MikeGomezS/mexa/main.py

# ============================================================
#  MEXA — Programa Principal (main.py)
#  WRO Future Innovators 2026
#  Equipo: Bruno, Emilia y Majo
#
#  Orquestador: une los módulos y corre el ciclo de exhibición.
#  El QUÉ dice MEXA vive en modulos/contenido.py, el CÓMO se
#  acerca en modulos/navegacion.py y la conversación en
#  modulos/dialogo.py. Acá sólo se inicia, se coordina y se apaga.
#
#  Para ejecutar: python3 main.py
#
#  ANTES DE CORRER: seguir los pasos 1 a 10 del README.txt. Están
#  ahí y NO acá a propósito. Este encabezado repetía las mismas
#  instrucciones, y el 2026-09-17 se encontró que las dos copias
#  habían divergido: las dos pedían `espeak` cuando el código llama
#  a `espeak-ng`, y `llama3.2:3b` cuando modulo_ia.py usa
#  `llama3.2:1b`. Dos copias de una instrucción no son un respaldo:
#  son dos lugares donde equivocarse y uno solo que alguien corrige.
#  UNA sola fuente de verdad — el README.
# ============================================================

import time

from modulos.modulo_ia          import warmup_llm
from modulos.modulo_tts         import presintetizar
from modulos.modulo_audio       import calibrar_ruido_ambiente
from modulos.modulo_sensores    import iniciar_sensores, detectar_persona
from modulos.modulo_motores     import iniciar_motores, detener
from modulos.modulo_camara      import (iniciar_camara, diagnosticar_enfoque,
                                        apagar_camara)
from modulos.modulo_proyector   import (iniciar_proyector, pantalla_bienvenida,
                                        apagar_proyector)
from modulos.modulo_brazos      import iniciar_brazos, cerrar_brazos
from modulos.conexion_arduino   import cerrar_conexion
from modulos.navegacion         import acercarse_a_usuario, retroceder
from modulos.dialogo            import ciclo_interaccion, esperar_activacion, Resultado
from modulos                    import contenido


def _presintetizar_todo() -> None:
    """Pre-sintetiza con Piper todas las frases fijas al arrancar para
    reproducción instantánea durante la interacción (sin latencia de síntesis)."""
    print("[MAIN] Pre-sintetizando frases fijas...")

    # Prompt de idioma (siempre en inglés, antes de saber la preferencia).
    frases = [
        "Hi, I am MEXA. Would you prefer Spanish or English?",  # _seleccionar_idioma
        "Please say 'español' or 'English'.",                   # _seleccionar_idioma
    ]

    # Frases dependientes del idioma y de cada civilización.
    for idioma in ("es", "en"):
        f = contenido.FRASES[idioma]
        nombres_civ = contenido.nombres_ofrecidos(idioma)
        oferta = ", ".join(nombres_civ)
        frases.append(f["saludo_civ"].format(oferta=oferta))
        frases.append(f["no_reconocio"].format(oferta=oferta))
        frases.append(f["no_entendio"])
        frases.append(f["despedida"])
        for nombre in nombres_civ:
            frases.append(f["intro_video"].format(nombre=nombre))
            frases.append(f["post_video"].format(nombre=nombre))

    for texto in frases:
        presintetizar(texto)

    print(f"[MAIN] {len(frases)} frases listas.")


def iniciar_todo():
    """Inicializa todos los módulos del robot."""
    print("=" * 50)
    print("  MEXA — Iniciando sistema...")
    print("=" * 50)

    iniciar_sensores()
    iniciar_motores()
    iniciar_camara()
    iniciar_proyector()
    iniciar_brazos()

    pantalla_bienvenida()

    # Optimizaciones de latencia: pre-sintetizar frases fijas y precalentar el
    # LLM para que la primera respuesta de IA no pague el costo de carga del modelo.
    _presintetizar_todo()
    warmup_llm()

    # DESPUÉS de la pre-síntesis a propósito: la cámara puede capturar 40 fps
    # de imagen inútil si el lente está velado, y el autofocus necesita unos
    # segundos para asentarse. Esos segundos ya los gastó el arranque acá
    # arriba, así que el diagnóstico sale gratis y llega a tiempo — antes de
    # que MEXA reciba al primer visitante y "no detecte caras" sin explicar
    # por qué.
    diagnosticar_enfoque()

    # ÚLTIMO paso a propósito: mide el ruido de la sala con todo ya
    # encendido (ventilador del proyector, cara animada) y con MEXA
    # callada. Ese ruido es el que va a haber durante toda la visita,
    # así que es el que el umbral de voz tiene que descontar. Calibrar
    # antes de encender el proyector daría un piso optimista.
    calibrar_ruido_ambiente()

    print("[MAIN] Todos los módulos iniciados. MEXA listo.")


def apagar_todo():
    """Apaga los módulos al salir (los GPIO viven en el Arduino, no en la Pi)."""
    print("[MAIN] Apagando MEXA...")
    detener()
    cerrar_brazos()
    cerrar_conexion()   # cierra el puerto serial compartido (un solo Arduino)
    apagar_camara()
    apagar_proyector()
    print("[MAIN] MEXA apagado correctamente.")


# Tras oír "comencemos", cuánto espera al PIR antes de volver a dormir (despertar falso).
ACTIVACION_PIR_TIMEOUT_S = 20


def _esperar_persona(timeout: float) -> bool:
    """Espera a que el PIR detecte a alguien, hasta `timeout` segundos.
    Devuelve True si apareció, False si venció el tiempo (nadie llegó)."""
    fin = time.time() + timeout
    while time.time() < fin:
        if detectar_persona():
            return True
        time.sleep(0.5)
    return False


def ciclo_principal():
    """
    Flujo de exhibición con activación por voz. MEXA duerme hasta que alguien
    dice "comencemos"; entonces detecta (PIR), se acerca, atiende y, al terminar,
    vuelve a dormir. Según el Resultado de ciclo_interaccion():
    APAGAR=apagar MEXA, ESPERAR=volver a reposo, REINICIAR=reiniciar en el lugar.
    """
    print("[MAIN] MEXA lista. Esperando activación por voz...")

    try:
        while True:
            # Reposo: dormir hasta oír "comencemos".
            esperar_activacion()

            # Activada: empezar la detección de la persona (PIR). Si nadie
            # aparece (despertar falso), volver a dormir en vez de colgarse.
            if not _esperar_persona(ACTIVACION_PIR_TIMEOUT_S):
                print("[MAIN] Activada pero nadie apareció. Vuelvo a reposo.")
                pantalla_bienvenida()
                continue

            print("[MAIN] ¡Persona detectada! Iniciando interacción.")

            # Centrar y acercarse al visitante con la cámara (lazo cerrado).
            # Guarda el recorrido para poder volver al punto de partida.
            camino = acercarse_a_usuario()

            # Atender al visitante. REINICIAR = volver a empezar en el lugar.
            resultado = ciclo_interaccion()
            while resultado is Resultado.REINICIAR:
                resultado = ciclo_interaccion()

            # Deshacer el acercamiento: MEXA retrocede a donde empezó.
            retroceder(camino)

            if resultado is Resultado.APAGAR:
                break

            # ESPERAR → volver a reposo, esperando otra activación por voz.
            pantalla_bienvenida()
            print("[MAIN] Interacción completada. Volviendo a reposo...")

    except KeyboardInterrupt:
        print("\n[MAIN] Interrupción detectada (Ctrl+C).")
    finally:
        apagar_todo()


# ── Punto de entrada ────────────────────────────────────────
if __name__ == "__main__":
    iniciar_todo()
    ciclo_principal()
