MikeGomezS/mexa/(commit log)

2026-06-15 refactor: reorganizar codigo en paquete modulos/ y tests/
    - Modulos, config, conexion_arduino, conocimiento y _cara_animada -> modulos/ (paquete)
    - Imports internos pasados a relativos (from .config, etc.)
    - Rutas de assets (media/, modelo_vosk_es) corregidas con '..' al subir un nivel
    - main.py importa desde modulos.*
    - test_flujo.py -> tests/ con bootstrap de sys.path
    - modulos/__init__.py creado
2026-06-15 feat(brazos): implementar gesto de servos en firmware
    - Servo.h con barrido no bloqueante (millis) en pines D10/D11
    - 'H' activa gesto al hablar, 'P' vuelve a reposo
    - brazosReposo() en setup para posicion inicial
    - Corregida doc de pines en modulo_brazos.py (D9/D10 -> D10/D11, D9 lo usa Motor 3)
    - Angulos parametrizados (BRAZO_REPOSO/MIN/MAX) para ajuste mecanico
2026-06-16 feat(sensores): mover presencia y evasion de paredes al Arduino Mega
    Presencia (2x PIR) y ultrasonicos (2x HC-SR04) pasan a leerse en el
    firmware del Arduino Mega; el serial se vuelve bidireccional.
    Firmware (mexa.ino):
    - corrige pines de servos (der=10, izq=11)
    - lee 2 PIR (der=24, izq=22) y reporta "PRES:0/1" (OR, cambio+heartbeat)
    - agrega 2 HC-SR04 (der TRIG29/ECHO28, izq TRIG31/ECHO30)
    - evitarPared() frena solo en giros (R->derecho, L->izquierdo), umbral 15cm
    - medicion con pulseIn de timeout corto (pines en PORTA no admiten interrupts)
    Pi:
    - conexion_arduino.py: agrega RX no bloqueante (_bombear, hay_presencia)
    - modulo_sensores.py: elimina RPi.GPIO, delega presencia en el serial
    -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
    [conexion_arduino.py, config.py, main.py, mexa.ino, modulo_sensores.py]
2026-06-16 feat(flujo): migrar optimizaciones de latencia y despedida por idioma a main.py
    - pre-sintetizar frases fijas (Piper) y precalentar el LLM al iniciar
    - despedida y no_entendio respetan el idioma elegido (como test_flujo)
    - agregar clave no_entendio a _FRASES (es/en)
    - eliminar hablar_despedida/hablar_no_entendio (codigo muerto sin llamadores)
    - limpiar import en tests/test_flujo.py
2026-06-16 chore(arduino): eliminar sketches legacy motores.ino y brazos.ino
    Superados por el firmware unificado arduino/mexa/mexa.ino (un solo Arduino
    = un solo sketch). El motores.ino vacio era el que corria y causaba que
    los motores no respondieran.
2026-06-16 fix(arduino): corregir puerto serial a /dev/ttyACM0 (Mega 2560 R3 original)
    La placa real es un Arduino Mega 2560 R3 genuino (USB 2341:0042, CDC ACM)
    en /dev/ttyACM0, no un clon CH340 en /dev/ttyUSB0. Con el puerto anterior
    el software no se conectaba al Arduino.
    [config.py]
2026-06-16 test(arduino): script interactivo de prueba manual de motores y brazos
    Lee una tecla a la vez y envia el comando de una letra al firmware
    (F/B/R/L/S, 1-4 identificar motor, H/P brazos). Hilo lector muestra
    OK/PRES/WALL. Al salir manda S+P (stop + reposo) por seguridad.
2026-06-16 feat(flujo): cerrar loop continuo de atencion en ciclo_principal
    ciclo_interaccion ahora propaga el retorno de _ciclo_preguntas
    (True=apagar, False=esperar persona, None=reiniciar) y ciclo_principal
    atiende visitante tras visitante en vez de una sola interaccion. Activa
    la logica de _PALABRAS_REINICIO/_PALABRAS_ADIOS que estaba muerta.
2026-06-16 test(sensores): agregar prueba end-to-end de presencia PIR
    Valida el camino Arduino (PRES:0/1) -> conexion_arduino -> detectar_persona()
    con lectura en vivo. Incluye aviso de calentamiento del HC-SR501.
2026-06-17 feat(camara): degradar con gracia cuando no hay camara conectada
    iniciar_camara() ya no aborta el arranque si la camara no esta presente;
    capturar_frame/detectar_cara/posicion_cara devuelven None/False, por lo que
    orientarse_a_usuario(None) queda como no-op seguro.
2026-06-17 refactor(main): quitar control de ventiladores por software
    Los ventiladores quedan siempre prendidos por hardware. Se eliminan el import,
    la constante INTERVALO_TEMP_S, iniciar_ventiladores(), encender_siempre() y el
    bloque de control termico en ciclo_principal. Se borra modulo_ventiladores.py,
    que quedo huerfano.
2026-06-17 chore(tests): eliminar test_flujo.py
    El flujo de interaccion ya vive en main.py (validado en hardware). test_flujo.py
    era una copia paralela que divergio (su _ciclo_preguntas devolvia solo bool y usaba
    _esperar_wakeword en vez de la logica de reinicio por 'mexa'). Se elimina para dejar
    main.py como unica fuente de verdad.
2026-06-17 feat(flujo): avanzar 3s al frente al detectar persona
    Al detectar presencia por PIR, MEXA avanza hacia el frente durante
    AVANCE_PERSONA_S (3s) y frena antes de iniciar la interaccion. Se dispara
    una sola vez por visitante nuevo (no en el reinicio por 'mexa').
2026-06-17 test(camara): agregar script de validación de cámara IMX708
2026-06-17 fix(camara): agregar timeout a capturar_frame para no congelar MEXA si cae el CSI
    [modulo_camara.py]
2026-06-22 feat(camara): robustecer detección y exponer localización de cara
    La detección Haar evalúa cada frame aislado y parpadea (el test marcó 22
    cambios de estado en 20s con una persona quieta). Se agregan dos filtros
    según el modo de uso:
    - detectar_cara(): filtro de persistencia (debounce temporal) con umbrales
    asimétricos (confirma presencia en 2 frames, la suelta en 4) para
    detección CONTINUA en loop.
    - posicion_cara(): muestreo por consenso (5 frames, voto por mayoría) para
    el modo one-shot, donde no hay loop sobre el cual suavizar.
    Además se expone localizar_cara() -> (posicion, tamano_rel), que devuelve la
    cara más grande con su tamaño relativo como proxy de distancia, p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
2026-06-22 feat(flujo): acercar a la persona en lazo cerrado con cámara
    Reemplaza el avance ciego de tiempo fijo (mover_por_tiempo adelante 3s) por
    acercarse_a_usuario(): un lazo cerrado que centra al visitante Y se le acerca
    usando el tamaño de la cara como proxy de distancia.
    El lazo vive en main.py (composition root) porque combina sensado (cámara) y
    actuación (motores), sin acoplar los módulos entre sí. Patrón pulso-frenar-
    sensar: nunca avanza a ciegas. Prioriza centrar antes que avanzar y frena al
    alcanzar TAMANO_CARA_OBJETIVO. Cortes de seguridad por timeout y por pérdida
    sostenida de cara. Loguea el tamaño de la primera cara enganchada como dato
    de calibración para el robot real.
    La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
2026-06-23 feat(vision): detección robusta con YuNet y acercamiento en dos fases
    - camara: migrar de Haar a YuNet (FaceDetectorYN, DNN) con score mínimo
    alto para alimentar el lazo de motores sólo con caras de alta confianza;
    robusto a blur, contraluz y fondo cargado
    - main: refinar acercarse_a_usuario con avance continuo (sensa en marcha),
    corrección de rumbo por pulsos con asentamiento anti-blur y empuje ciego
    final al perder la cara por recorte de cercanía
    - tests: agregar scripts de diagnóstico y calibración (deteccion, motores,
    acercamiento, pulsos, avance)
    - agregar modelo face_detection_yunet_2023mar.onnx
    - gitignore: excluir frames de diagnóstico de cámara
2026-06-23 feat(flujo): retroceder al punto de partida deshaciendo el camino del acercamiento
    MEXA registra cada comando de motor (F/B/R/L/S) con su timestamp durante
    el acercamiento y, tras atender al visitante, deshace el recorrido en orden
    inverso (F<->B, R<->L) para volver a donde empezó.
    - registro_camino: logica pura calcular_camino_inverso() (testeada, 7/7) +
    RegistroCamino/retroceder() que se enganchan a la capa serial via un
    observador en conexion_arduino.enviar(). Imports de hardware perezosos
    para que el modulo corra en cualquier maquina.
    - retroceder() expone factor_duracion para corregir la asimetria
    avance/reversa (inercia, patinaje), pendiente de calibrar en hardware.
    - acercar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
    [calibrar_retroceso.py, conexion_arduino.py, main.py, registro_camino.py, test_registro_camino.py]
2026-06-24 feat(flujo): giro de centrado más fluido (PULSO_GIRO_S 0.25 -> 0.80)
2026-06-24 feat(interaccion): "terminar" apaga, "adios" espera al próximo, "empecemos de nuevo" reinicia
2026-06-24 refactor(arquitectura): separar main en contenido/navegacion/dialogo + Enum Resultado + fix matcher de voz
    [contenido.py, dialogo.py, main.py, modulo_camara.py, navegacion.py, test_camara.py]
2026-08-21 feat(idioma): MEXA bilingüe real — oído en inglés con segundo modelo Vosk
    El modelo Vosk español no tiene los fonemas /ɪ/ ni /ʃ/: con audio limpio
    todavía forzaba "English" contra su entrada léxica, pero con micrófono
    lejano y ruido de sala ese margen desaparecía y decodificaba cualquier
    cosa (medido: "web"). Un oído español no escucha inglés.
    - modulo_audio: segundo modelo Vosk (en-us) y gramática CERRADA para la
    pregunta de idioma — una pregunta cerrada merece un grafo cerrado: el
    decodificador elige entre 3 palabras, no entre 300 mil.
    - dialogo: el idioma elegido se propaga a TODA la conversación
    (escuchar_pregunta, elección de civilización, ciclo de preguntas)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
2026-08-21 fix(camara): elegir a QUIÉN mira MEXA, y arreglar el color que la dejaba ciega
    Con varias personas juntas MEXA no sabía a quién atender. Al medir sobre
    tests/diag_frames/ aparecieron dos problemas, uno encima del otro.
    1. ORDEN DE CANALES (la causa de fondo). _buscar_caras hacía un
    cvtColor(RGB2BGR) de más: picamera2 en 'RGB888' YA entrega los bytes
    en orden BGR, que es lo que YuNet espera. Se le estaba dando al
    detector una imagen con R y B cruzados. Medido sobre 20 frames reales:
    cruzado detecta cara en 6/20 (scores 0.38-0.89); correcto, en 17/20
    (scores 0.80-0.93), y desaparece un falso positivo sobre un reloj de
    pared. Ninguna muestra empeoró. Segunda evidencia,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
    [dialogo.py, modulo_camara.py, navegacion.py, test_seleccion_objetivo.py]
2026-08-21 feat(camara): mostrar en la corrida real a quién elige MEXA y por qué
    Validar la elección de objetivo exigía correr un diagnóstico aparte. Ahora
    el propio main.py lo cuenta: al enganchar un objetivo y al cambiar de
    persona, se imprime el puntaje de CADA cara visible, su tamaño, su posición
    y si mira a MEXA o está de perfil.
    [CAMARA] Objetivo: CAMBIA a 1 de 2 cara(s) visible(s).
    [CAMARA] -> puntaje=0.81 tam=22% derecha de frente (frontalidad=1.00)
    [CAMARA] puntaje=0.41 tam=22% izquierda de perfil (frontalidad=0.00)
    Habla sólo cuando pasa algo (enganche, cambio, objetivo soltado), nunca por
    frame: el lazo de acercamiento sensa decenas de veces por segundo y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
2026-08-21 chore(tests): borrar diagnostico_deteccion.py
    Su único trabajo era mostrar a quién elegía la cámara, y eso ahora lo dice
    MEXA sola durante la corrida real (líneas "[CAMARA] Objetivo:"). Mantener
    una segunda copia de la misma cadena de percepción sólo garantizaba que
    las dos se fueran separando con el tiempo.
2026-08-21 feat(ultrasonicos): MEXA mide la distancia REAL al visitante con 2 HC-SR04 frontales
    Antes MEXA cerraba el acercamiento con un empuje A CIEGAS de 4 segundos: la
    cámara pierde la cara justo cuando más cerca está, y a partir de ahí el robot
    avanzaba a fe. Ahora hay dos ultrasónicos frontales que miden cuánto falta.
    Firmware (arduino/mexa/mexa.ino):
    - 2 HC-SR04 nuevos al frente (DER D53/D52, IZQ D51/D50) sumados a los laterales.
    - Emite "DIST:<izq>,<der>" mientras avanza y "STOP:<cm>" si frena solo.
    - El freno vive en el Arduino porque es un REFLEJO, no una decisión: la Pi puede
    estar decodificando voz cuando el visitante da un paso al frente; el Arduino no.
    - Se MIDE cada 60ms pero s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
2026-08-24 feat(tests): auditar qué palabras puede oír MEXA de verdad
    Una clave de CIVILIZACIONES cuya palabra no está en el léxico del modelo
    Vosk es código muerto: el match nunca se cumple y no hay forma de notarlo
    leyendo el código. El video existe, la clave existe, y el visitante igual
    recibe "no reconocí esa civilización" hasta que MEXA se rinde.
    Tres modos, de más barato a más caro:
    auditar → consulta el léxico con vosk_model_find_word. Instantáneo, sin
    micrófono. Responde "¿esta clave puede funcionar alguna vez?".
    tts → sintetiza con Piper, degrada a condiciones de sala y se lo da
    al mismo recognizer libre que usa escuchar_pregunta. Captura la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
2026-08-24 fix(voz): MEXA ya no proyecta el video que nadie pidió
    Dos bugs con el mismo síntoma —el visitante recibe una civilización que no
    eligió— y causas distintas.
    1. MATCH POR SUBCADENA. La clave "mexica" vivía dentro de "mexicana",
    "mexicano" y "mexican", que Vosk escribe seguido porque están en ambos
    léxicos. "quiero saber de la comida mexicana" proyectaba los Aztecas.
    Medido: 8 de 11 frases inocentes disparaban un video. Ahora se compara
    por PALABRA COMPLETA. Eso rompe el truco de que el singular cubra al
    plural, así que se agrega "aztecs": se verificó clave por clave, con
    sufijos s/es/as/os contra ambos léxicos, que era la única forma derivada
    que el recon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
    [contenido.py, dialogo.py, test_civilizaciones.py]
2026-08-26 fix(tests): recuperar la carpeta tests/ del repo, tapada por speechrecognition
    `python3 -m tests.test_idioma` fallaba con "No module named tests.test_idioma"
    para TODOS los tests del proyecto, aunque los archivos estén ahí y sus propios
    docstrings digan que se corren así. Se venía corriendo `python3 tests/x.py`
    como workaround sin saber por qué hacía falta.
    La causa es un choque de nombres: speechrecognition-3.14.5 publica un paquete
    `tests` de nivel raíz en site-packages. Sin __init__.py, la carpeta tests/ de
    este repo es un "namespace package": Python la anota como candidata pero SIGUE
    buscando, y en cuanto encuentra un paquete REGULAR con el mismo nombre más
    adelante en sys.path,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
2026-08-26 feat(vad): MEXA distingue la voz del visitante del ruido de la sala
    El VAD comparaba la energía del micrófono contra un número FIJO (300 RMS)
    calibrado en un cuarto tranquilo. Medido con el micrófono de MEXA en su propia
    sala, el piso de ruido va de 385 a 1615 RMS según el momento: el umbral estaba
    POR DEBAJO del ruido y el VAD ya estaba PEGADO —nunca juntaba 1.5s de silencio,
    se comía el timeout entero y le entregaba ruido a Vosk— antes de llegar a la
    expo. Un número fijo mide VOLUMEN, no voz, y falla en las DOS direcciones: en
    sala ruidosa nunca cierra, y con un visitante que habla bajo nunca abre.
    UMBRAL RELATIVO AL RUIDO MEDIDO (modulos/vad.py, nuevo)
    - El umbral se deriva de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
2026-08-27 fix(vad): el calibrador de voz medía contra un detector que no corría
    El veredicto de tests/calibrar_umbral_voz.py salía de umbral_desde_piso(),
    que usa _FACTOR_UMBRAL (3.0), el umbral del DetectorVoz de energía. Cuando
    Silero está instalado el que corre es DetectorVozNeural, cuya compuerta es
    _FACTOR_ENERGIA_NEURAL (2.0) — más baja a propósito, porque ahí la energía
    no tiene que rechazar golpes: de eso ya se encarga Silero.
    Medido en sala con piso 357: juzgaba contra 1071 en vez de 714 y reportaba
    "JUSTO 1.1x" para voz baja cuando el margen real era 1.6x. Falsa alarma.
    Causa raíz: cada detector exponía su umbral con un nombre distinto
    (.umbral vs .umbral_energia), así que el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
    [calibrar_umbral_voz.py, vad.py]
2026-08-27 feat(tests): medir si la señal cae como 1/distancia sin fuente reproducible
    Para decidir la altura del micrófono hace falta saber cuánto se gana
    subiéndolo. Altura y distancia son la MISMA hipotenusa
    (√(horizontal² + Δaltura²)), así que si la señal cae como 1/distancia
    alcanza con medir a distintas DISTANCIAS —que es gratis, caminás— para
    predecir el efecto de cambiar la ALTURA, sin desmontar nada.
    El problema es que la fuente de sonido es una persona y una persona no es
    reproducible. Medido con el mismo usuario, misma sala y mismo día: la
    relación entre su "voz normal" y su "voz baja" pasó de 1.32x en una
    corrida a 3.72x en la siguiente. Ese ruido del instrumento es MAYO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
    [calibrar_distancia_voz.py]
2026-08-27 feat(audio): banco de pruebas del cancelador de eco, para saber si MEXA puede ser interrumpida
    MEXA se tapa los oídos mientras habla (_vaciar_buffer): nadie puede
    interrumpirla, hay que esperar el video entero. El commit c445133 cerró
    diciendo que el AEC "no es un pendiente sino otro proyecto" porque pygame y
    PyAudio no comparten reloj. ESO ERA INCORRECTO. Cierto entre aplicaciones,
    irrelevante acá: PipeWire ve los dos lados con el mismo reloj y puede restar.
    El AEC es viable en la Pi actual, sin comprar nada.
    Este commit NO habilita el barge-in. Agrega la config y el banco de pruebas
    que tiene que aprobarla antes de tocar una línea del camino de audio.
    LA CONFIG, AHORA EN EL REPO (con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
2026-08-27 fix(audio): medir la referencia, sin la cual el veredicto del AEC es una adivinanza
    La primera PRUEBA C corrida por una persona dio "NO SIRVE PARA BARGE-IN" sobre
    una medición físicamente imposible:
    PRUEBA A (solo eco) crudo 2895 RMS
    PRUEBA B (solo voz) crudo 1631 RMS
    PRUEBA C (las dos) crudo 1392 RMS
    Dos fuentes suman EN POTENCIA: juntas tendrían que dar ~3323 y nunca pueden
    dar menos que la más fuerte por separado. Medir 1392 significa que el parlante
    no estaba reproduciendo durante la C. El script verificaba que hubiera eco en
    A y voz en B, pero nunca que en C estuvieran LAS DOS, así que emitió el
    veredicto que más importa —el del barge-in— sobre datos que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
    [calibrar_aec.py]
2026-08-27 feat(audio): MEXA escucha por PipeWire, para que el cancelador de eco le sirva de algo
    MEXA tenía un pie adentro y otro afuera del servidor de sonido: la salida
    (pw-play del TTS, cvlc del video) iba por PipeWire, pero la entrada la abría
    PyAudio directo contra ALSA. PipeWire nunca veía el micrófono, así que no
    podía restarle nada. El cancelador de eco estaba cargado, medido y aprobado
    —22.1 dB sobre el eco, la voz sobreviviendo en doble conversación— y no
    compraba NADA, porque el audio que llegaba a Vosk nunca pasaba por él.
    Ahora la captura sale de un `pw-record` apuntando a `mexa_aec_source`.
    POR QUÉ pw-record Y NO pipewire-alsa
    El plugin ALSA estaba disponible en apt y el c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
2026-08-27 fix(audio): no confiar en el cancelador sin mirar a qué micrófono está enchufado
    elegir_nodo() verificaba que `mexa_aec_source` EXISTIERA y se conformaba con
    eso. No alcanza, y el modo de falla es el peor posible.
    El módulo echo-cancel se carga junto con el daemon de PipeWire, ANTES de que
    los dispositivos estén publicados. Si el iTalk-02 todavía no existe,
    target.object no encuentra a quién apuntar y WirePlumber engancha la captura
    al dispositivo por defecto de ese instante. Visto en hardware el 2026-08-27:
    quedó enganchado a un micrófono Bluetooth. El nodo seguía existiendo, seguía
    entregando muestras, y eran CEROS. Sin error, sin log, sin nada: MEXA
    completamente sorda en plen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
    [captura.py, test_captura.py]
2026-08-27 feat(tests): probar si MEXA ENTIENDE a quien le habla encima, no si lo oye
    tests/calibrar_aec.py mide ENERGÍA y ya dio su veredicto: la voz sobrevive a
    la doble conversación. Pero su PRUEBA C aprobó con 1830 RMS de salida, y ese
    número es compatible con la voz y el eco fugado MEZCLADOS — con un solo canal
    no hay forma de separarlos. Que la voz tenga volumen no prueba que se
    entienda, y lo que MEXA necesita es entender.
    Eso sólo lo contesta el reconocedor. Este script mide la decisión REAL de
    MEXA: `_dijo(texto, _PALABRAS_ACTIVACION)` sobre lo que devuelve
    `escuchar_multilingue()`. No un proxy ni una transcripción parecida: si
    despierta o no despierta.
    EL DISEÑO: DOS CAMINOS, UNA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
2026-08-27 fix(tests): el wake word era la métrica equivocada y hacía ganar al micrófono sucio
    La primera corrida real con voz humana dio este veredicto:
    el visitante DESPERTÓ a MEXA con cancelador 2/3 sin cancelador 3/3
    SIRVE, PERO EL CANCELADOR NO ES LO QUE LO LOGRA
    Ese veredicto es engañoso, y la culpa es de la métrica que eligió este
    script, no del cancelador. Lo que devolvió cada camino en el mismo intento,
    sobre la MISMA voz y el MISMO instante:
    con cancelador "comencemos" 1 palabra, 0 fantasma
    micrófono crudo "hoy vamos a de comprar el 9 palabras, 8 fantasma
    imperio comencemos hola"
    En los tres intentos: 5 palab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
    [probar_barge_in.py]
2026-08-27 fix(tests): avisar CUÁNDO hablar con tiempo de reaccionar, y no inclinar la comparación
    La señal para hablar era un "¡AHORA!" impreso de golpe, seguido de inmediato
    por la ventana de escucha. No alcanza: para cuando la persona lee el aviso,
    el video ya está sonando fuerte, la consola está escupiendo líneas del
    reconocedor y la ventana ya arrancó. En la corrida real el aviso se perdió y
    la medición se fue con él.
    Y el modo de falla es traicionero: una señal perdida produce "el visitante no
    despertó a MEXA", que se lee como un fallo del CANCELADOR cuando en realidad
    es un fallo del BANCO DE PRUEBAS. Un test que no distingue esas dos cosas
    miente sobre lo que mide.
    Ahora hay cuen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
    [probar_barge_in.py]
2026-09-09 fix(audio): buscar el micrófono en el grafo, porque un nombre a mano no avisa cuando muere
    El nodo de captura del cancelador apuntaba a un nombre escrito a mano:
    target.object = "alsa_input.usb-Clip-on_USB_microphone_iTalk-02-00.mono-fallback"
    El 2026-09-08 se cambió el clip-on por un lavalier inalámbrico y ese nombre
    dejó de existir. Lo grave no fue quedarse sin nodo: fue que NADIE SE ENTERÓ.
    pw-record --target <nodo-que-no-existe> NO FALLA.
    Cae al micrófono por defecto y sigue entregando audio como si nada. Medido
    ese día: 156614 bytes de audio REAL leídos de un nodo inexistente, que
    resultaron ser el micrófono del parlante Bluetooth. O sea que la degradación
    "caigo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
    [captura.py]
2026-09-09 perf(voz): cortar a 0.9s de silencio, medido, en vez de esperar 1.5s siempre
    MEXA tardaba en darse por contestada. La espera de silencio era una constante
    global de 1.5 s: el visitante decía "español" y MEXA se quedaba escuchando
    un segundo y medio de nada antes de reaccionar.
    EL NÚMERO NUEVO ESTÁ MEDIDO, no elegido a ojo. Barrido con voz real y Silero:
    silencio tarda en cortar tolera pausas de hasta
    0.6 s +0.61 s 0.4 s
    0.8 s +0.84 s 0.6 s
    0.9 s +0.93 s 0.8 s <- elegido
    1.5 s +1.51 s 1.3 s (el valor viejo)
    No se baja a 0.6 aunque sea más rápido: "los... eh... olmec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
2026-09-09 fix(voz): un solo pw-play para toda la respuesta, que el corte era renegociar Bluetooth
    La voz se escuchaba cortada entre frase y frase. La causa no estaba en el
    sintetizador: _reproducir_con_volumen lanzaba UN pw-play POR ORACIÓN. Proceso
    nuevo, stream de PipeWire nuevo y —lo caro— una NEGOCIACIÓN NUEVA CON EL
    PARLANTE BLUETOOTH en cada punto seguido.
    Medido: 3 oraciones con un proceso por oración agregan +0.81 s de silencio
    repartido entre frases; con un solo stream abierto, +0.06 s.
    Ahora _abrir_reproductor() deja UN pw-play vivo comiendo PCM crudo por stdin
    para toda la respuesta.
    El segundo defecto era la DERIVA DE LOS SLEEPS. El envío de volumen a la cara
    dormía un tiempo f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
    [modulo_tts.py]
2026-09-09 perf(ia): dejar de reenviar en cada turno los hechos de las preguntas viejas
    El historial guardaba f"{contexto}\n\nPregunta: {pregunta}" completo, así que
    los ~400 caracteres de hechos de CADA pregunta vieja viajaban otra vez en
    cada turno: hasta 1200 caracteres de material ya consumido.
    Eso se paga caro. Procesar el prompt en esta Pi cuesta entre 5 y 25 segundos,
    MEDIDO, y es lo primero que espera el visitante — antes de que se genere un
    solo token. El historial existe para que MEXA entienda "¿y quién la
    construyó?", no para volver a suministrarle datos que ya usó.
    Ahora _mensajes() arma sistema + historial limpio + la pregunta actual CON
    sus hechos: el contexto va SÓLO en el turn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
2026-09-09 fix(conocimiento): MEXA no entendía en inglés porque las 170 claves eran en español
    Se reportó que "le cuesta trabajo entender cuando hablamos en inglés". NO era
    el reconocimiento de voz: la transcripción llegaba PERFECTA.
    Las ~170 palabras clave de la base de conocimiento estaban TODAS en español.
    Con la transcripción correcta en inglés, 7 de 10 temas devolvían CERO hechos,
    así que la IA contestaba sin material: un visitante que pregunta "who built
    the pyramid of the sun?" recibía una respuesta genérica, no la de MEXA.
    Ahora cada tema lleva sus claves en los dos idiomas ("pyramid of the sun",
    "feathered serpent", "sun stone", "ball game"...), y el test nuevo verifica
    tema por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
    [conocimiento.py, test_conocimiento_bilingue.py]
2026-09-09 fix(contenido): una sola lista de civilizaciones y una gramática que Vosk no descarte
    Tres defectos de la elección de civilización, encontrados auditando el
    catálogo contra el disco.
    1. VOSK PERDÍA "TEOTIHUACÁN" EN SILENCIO
    dialogo.py serializaba la gramática con json.dumps por defecto, o sea
    ensure_ascii=True: "teotihuacán" viajaba como el literal teotihuacán.
    Vosk NO DESESCAPA. Busca esa cadena tal cual, no la encuentra y descarta la
    palabra —lo avisa con "Ignoring word missing in vocabulary", enterrado entre
    sus propios logs—. El oído español perdía Teotihuacán entera y nadie lo veía.
    Ahora contenido.gramaticas_json() serializa con ensure_ascii=False, y ese es
    el punt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
    [contenido.py, main.py, test_civilizaciones.py, test_deteccion_civilizacion.py]
2026-09-09 feat(cara): doce expresiones y una sola ventana que el panel del escritorio no tape
    La cara de MEXA tenía un repertorio mínimo y dos defectos de ventana que se
    veían en el proyector delante de la gente.
    EXPRESIONES. Doce estados dibujados (dormido, escuchando, feliz, sorprendido,
    confundido, pensando...) en vez del puñado anterior, con la paleta extraída a
    constantes nombradas al tope del módulo (FONDO, TINTA, ESCLERA, BOCA, RUBOR).
    Antes esos colores eran números mágicos repetidos por todo _dibujar(): cambiar
    el fondo obligaba a cazarlos de a uno. El fondo pasó de verde a azul MEXA.
    VENTANA DUPLICADA. iniciar_proyector() abría una ventana pygame en el proceso
    principal que queda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
2026-09-09 fix(dialogo): las palabras de control apagaban a MEXA dentro de una pregunta legítima
    DOS COSAS, las dos sobre el mismo archivo.
    1. EL BUG QUE APAGABA A MEXA SOLA
    _PALABRAS_APAGAR, _PALABRAS_SALIDA y _PALABRAS_REINICIO se comparaban con
    _dijo() contra la pregunta LIBRE del visitante, que llega con vocabulario
    ABIERTO. _dijo() matchea palabra completa en CUALQUIER parte de la frase, así
    que una pregunta perfectamente legítima disparaba el control:
    "¿por qué NO se sabe quién construyó Teotihuacán?" -> se apagaba
    "¿cómo TERMINÓ la civilización maya?" -> cortaba la charla
    El visitante no estaba dando una orden: estaba preguntando. Ahora una palabra
    de con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
    [dialogo.py, test_expresiones.py, test_palabras_control.py]
2026-09-09 fix(navegacion): el regreso anotaba giros que el firmware había cancelado
    MEXA volvía mal al punto de partida. Tres causas, la primera es la cara.
    1. EL "WALL:I/D" SE TIRABA A LA BASURA
    El firmware frena SOLO: durante un 'R'/'L' mide el lateral de ese lado y si
    hay pared a menos de UMBRAL_PARED_CM cancela el giro y lo avisa con "WALL:I/D"
    (arduino/mexa/mexa.ino:219-232). Del otro lado nadie escuchaba: la señal
    llegaba a la Pi y se descartaba.
    El lazo giraba con mover_por_tiempo(), o sea un sleep CIEGO. Sigue durmiendo
    el pulso entero aunque el firmware haya cortado a la décima parte, y recién
    ahí manda su 'S' — así que EL REGISTRO DEL CAMINO ANOTA UN GIRO QUE NO PASÓ.
    Y ese err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
    [calibrar_acercamiento.py, calibrar_pulsos.py, calibrar_retroceso.py, conexion_arduino.py, modulo_motores.py, navegacion.py, registro_camino.py, test_registro_camino.py]
2026-09-09 feat(camara): avisar cuando el lente está velado, en vez de no detectar caras y callarse
    La cámara estuvo días entregando imagen sin foco y el sistema nunca avisó. El
    único síntoma era "MEXA no detecta a nadie", que se lee como un problema de
    YuNet, de la luz o del visitante — cualquier cosa menos la óptica.
    Medido en hardware: la IMX708 enumera y captura PERFECTO (30/30 frames, ~40
    fps, latencia mediana 20 ms, exposición sana Lux 247) y aun así YuNet detecta
    0/30 caras. Barrido MANUAL de LensPosition 0->32 con AfMode=0: nitidez PLANA
    2.5-3.2 en todo el recorrido, sin pico de foco en ninguna posición. El RAW
    SBGGR16 sin comprimir tampoco tiene detalle, lo que descarta al ISP.
    A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
    [main.py, modulo_camara.py]
2026-09-09 feat(navegacion): MEXA se acerca por ultrasonido cuando la cámara no ve ni una cara
    MEXA no tenía NINGÚN camino de movimiento que no pasara por la visión,
    teniendo cuatro ultrasónicos ociosos.
    acercarse_a_usuario() está gateado de punta a punta por la cámara:
    asegurar_avance() —la única que manda 'F'— vive dentro de la rama
    posicion == "centro" de una lectura REAL de cara. Y _empuje_final() no
    rescata, porque su guarda `cerca and centrada` se evalúa contra
    ult_tamano = 0.0: cubre "vi la cara y la perdí de cerca", nunca "no vi
    ninguna cara".
    PROBADO, no inferido: con monkeypatch de enviar (motores desconectados,
    cámara real velada), acercarse_a_usuario() duró 0.9 s y mandó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
2026-09-17 feat(dialogo): MEXA solo contesta sobre las siete civilizaciones, y entiende los seguimientos
    La restricción existía, pero vivía en el prompt de sistema de modulo_ia.py
    redactada como prohibición negativa: "si te preguntan algo que no es sobre
    México, responde que solo puedes hablar de esos temas". Eso no es una
    restricción dirigida a llama3.2:1b, es un deseo. Es el MISMO motivo que ya
    documenta conocimiento.buscar_contexto sobre el contexto inyectado: un modelo
    de mil millones de parámetros no tiene con qué sostener una regla así.
    Y había un agujero peor debajo. Si buscar_contexto() no encontraba palabras
    clave devolvía "", y modulo_ia mandaba la pregunta al modelo SIN UN SOLO H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
2026-09-17 refactor(proyector): sacar las imágenes fijas, que la cara animada tapaba a los 0.7s
    No eran código muerto declarado: eran código que PARECÍA andar. mostrar_imagen
    mataba el subproceso de la cara para pintar la foto del sitio, y el
    cambiar_expresion("hablando") de la línea siguiente lo relanzaba enseguida,
    tapándola. La cara tarda ~0.7 s en aparecer (medido y documentado en
    _esperar_cara_lista), así que la imagen se veía ese rato y desaparecía ANTES
    de que MEXA dijera una palabra.
    Es una REGRESIÓN, no un diseño: mostrar_segun_tema es anterior a la cara
    animada (existía en 5bde199) y la cara le tomó el proyector en de60400. En un
    proyector no entran las dos cosas, y la cara es l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
2026-09-17 fix(proyector): el proyector no muestra texto, y el video faltante ya no se ve
    mostrar_texto() dibujaba un cartel en pantalla completa y tenía UN solo
    llamador: reproducir_video, con "Video no disponible". Un cartel de error
    proyectado en la cara de un jurado de la WRO es peor que cualquier falla
    silenciosa, así que se va la función entera.
    EL ORDEN ERA EL PROBLEMA DE FONDO, no el cartel. reproducir_video mataba la
    cara, abría la ventana de pygame y RECIÉN entonces miraba si el archivo
    existía:
    _desactivar_cara()
    iniciar_proyector()
    if not os.path.exists(ruta_video): <-- tarde
    Con eso, un video faltante ya había destruido el estado de la pantalla antes
    de saberlo, y l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
    [modulo_proyector.py]
2026-09-17 refactor(cara): sacar "enojado", una expresión que nadie iba a ver nunca
    De las 12 poses de POSES, once estaban cableadas en el diálogo y "enojado"
    no. test_expresiones ya la reportaba como "sin cablear (no es error)", y ese
    "no es error" se venía arrastrando desde que se agregaron las doce.
    No es error, pero tampoco es neutro: MEXA es una guía de museo y NO TIENE
    ninguna rama del diálogo donde enojarse. No es que falte cablearla — es que
    no hay dónde. Una pose que no se puede alcanzar es una cara que nadie va a
    ver, y dejarla sugiere que falta trabajo cuando lo que falta es borrarla.
    Se va de los tres lugares donde vivía: la pose en POSES, el listado del
    docstring de cabecera y e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
    [_cara_animada.py, probar_caras.py]
2026-09-17 docs(limpieza): sacar de la documentación todo lo que ya no era cierto
    Ocho desajustes entre el código y lo que la documentación afirmaba. Tres de
    ellos impedían instalar MEXA desde cero, y el error aparecía recién al
    ejecutar, nunca al instalar:
    - pyserial FALTABA en requirements.txt, y conexion_arduino.py hace
    `import serial`. Instalación limpia = MEXA sin poder moverse.
    - README y main.py pedían `ollama pull llama3.2:3b`; modulo_ia.py usa
    llama3.2:1b en sus tres llamadas.
    - README y main.py pedían `apt install espeak`; modulo_tts.py invoca el
    binario espeak-ng, que es otro paquete.
    Tres pasos obligatorios que directamente no estaban documentados: las voces
    de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
    [config.py, main.py, modulo_proyector.py]
2026-09-17 fix(cara): MEXA piensa mientras piensa, en vez de "hablar" en silencio 3 segundos
    En _ciclo_preguntas había dos cambiar_expresion pegados:
    cambiar_expresion("pensando")
    cambiar_expresion("hablando")
    hablar_stream(generar_respuesta_stream(pregunta))
    "pensando" no se veía NUNCA. hablar_stream consume el generador, así que los
    5-25 s de procesamiento de prompt pasaban con la cara ya puesta en "hablando":
    boca lista, cero audio. El visitante veía a MEXA "hablando" en silencio justo
    en la espera más larga de la conversación, en CADA pregunta.
    Y no se arreglaba dejando "pensando" puesta: tiene boca_vol=0, así que MEXA
    habría hablado con la boca congelada — el mismo error q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
    [dialogo.py, modulo_tts.py, test_expresiones.py]
2026-09-17 docs(validaciones): registrar qué se probó en el robot, donde sí se pueda corregir
    Cinco commits terminan con "PENDIENTE de validar en hardware:". Esa línea es
    útil el día que se escribe y ENGAÑOSA tres meses después, porque un mensaje de
    commit registra lo que se sabía EN SU MOMENTO y no se actualiza nunca.
    Y ya costó: hoy, al inventariar pendientes, se leyó el "PENDIENTE: calibrar
    factor_duracion" de ac8086d (2026-06-23) y se declaró abierto y urgente un
    tema que las presentaciones habían resuelto hacía meses. Peor: se justificó
    mirando `factor_avance=1.0` en el código y concluyendo "sin calibrar", cuando
    1.0 resultó ser el valor CORRECTO para este robot. El default estab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
2026-09-17 refactor: sacar el código que nadie llamaba y los comentarios que mentían
    Auditoría con un analizador AST que cruza TODA definición de modulos/ y
    main.py contra las referencias de TODO el repo, tests incluidos. Dio tres
    candidatos; los tres se verificaron a mano con grep antes de tocar nada, y los
    tres eran reales.
    1. modulo_ia.generar_respuesta — GEMELA MUERTA
    Misma lógica que generar_respuesta_stream: mismo prompt, mismo historial,
    misma base de conocimiento, pero devolviendo el texto entero. Cero llamadores:
    dialogo usa sólo la versión stream, porque esperar la respuesta completa son
    ~12 s de robot mudo (medido a 6.8 tokens/s en esta Pi).
    Y el costo ya se estaba pagando HOY: a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
